libc0607/nfc-errrrror-v2/hardware/Schematic_nfc-errrrror-v2_2021-07-05.pdf

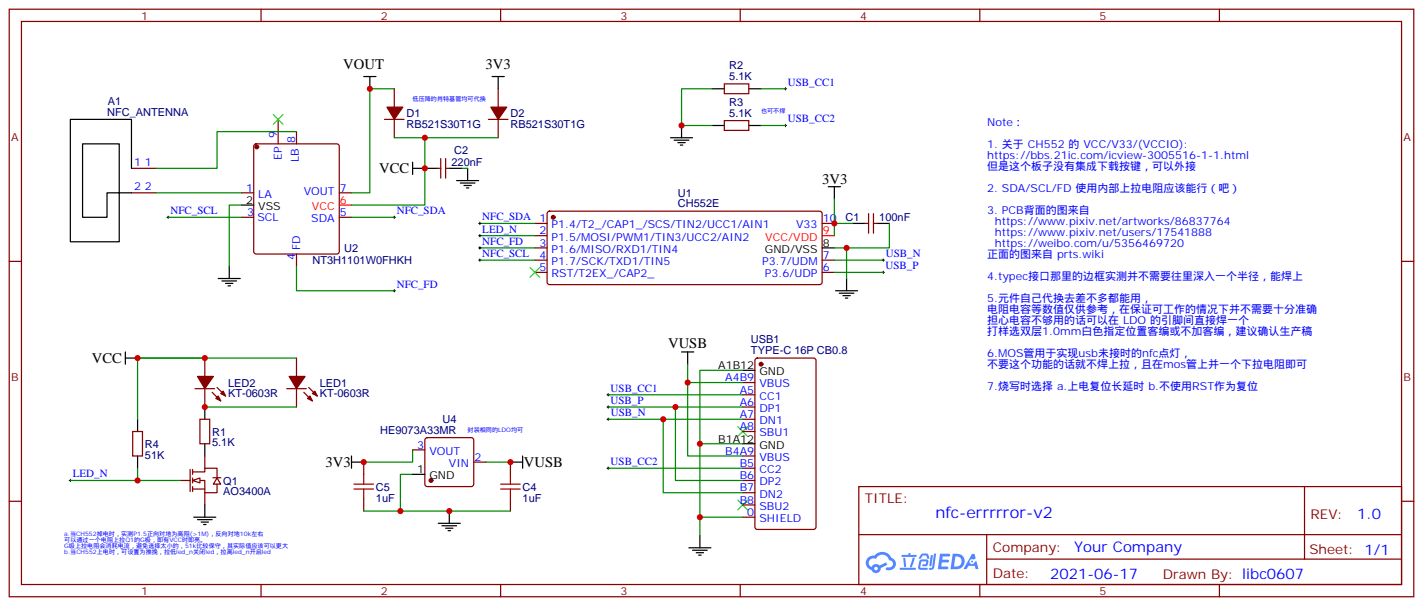
[picture p4: page 1]

Note：
1. 关于 CH552 的 VCC/V33/(VCCIO):
https://bbs.21ic.com/icview-3005516-1-1.html
但是这个板子没有集成下载按键，可以外接
2. SDA/SCL/FD 使用内部上拉电阻应该能行（吧）

3. PCB背面的图来自
https://www.pixiv.net/artworks/86837764
https://www.pixiv.net/users/17541888
https://weibo.com/u/5356469720
正面的图来自 prts.wiki
